PashaShun/PCB_Design/stm32f103/СП_СП1_merged.pdf

Формат
Кіл.
А4 | | ДК81.463421.001 ПЕ3 | Плата STM32F103С8T. Перелік елементів | 1
А3 | 4 Поз. | ДК81.463421.001 Е3 | Плата STM32F103С8T. Схема електрична принципова | 1
А2 | | ДК81.750706.001 СК | Плата. Складальне креслення | 1
А3 | 1
2 | C-0603 63 В 1 мкФ 10% Kemet | 1 | C1
3 | C-0603 63 В 20 пФ 10% Kemet | 4 | C2-C5
| C-0603 63 В 100 нФ 10% Kemet | 2 | C6,C7
5 | CASE-C_6032 63 В 330 мкФ 10% Kemet | 1 | C8
6 | C-0603 63 В 100 нФ 10% Kemet | 3 | C9-C11
7 | CASE-C_6032 63 В 100 мкФ 10% Kemet | 1 | C12
| 8 | | C-0603 63 В 100 нФ 10% Kemet | 1 | C13
| 9 | | CASE-C_6032 63 В 100 мкФ 10% Kemet | 1 | C14
Зм. | Лист | № докум. | Підп. | Дата
Аркушів
2

Інші вироби

Деталі

Документація

Підп. та дата

# ДК81.750706.001 СП

Інв. № подл.

Н. контр.
Затв. | Губар В.Ч.

Розроб.
Перев.

Аркуш

## Функціональний

1

годинник | НТУУ "КПІ Ім. Ігоря Сікорського" ФЕЛ, ДК-81
Шунь П.О. | Літ.
Адаменко І.О.

Конденсатори

Друкована плата

ДК81.463421.001

Справ. №
1
Позначення | Найменування

Підп. та дата

Примітки

Перв. застосув.

Зона

Взам. інв. № Інв. № дубл.

Копировал | Формат А4

Формат
Кіл.
15 Поз. 10 | TC2117-3.3VDBTR Microchip | 1 | DA1
11 | STM32F103VBH7 STMicroelectronics | 1 | DD1

2

13 | R-0603 0.1 Вт 10 кОм 10% Yageo | 1 | R1
14 | R-0603 0.1 Вт 100 кОм 10% Yageo | 2 | R2,R3
| R-0603 0.1 Вт 1 МОм 10% Yageo | 1 | R4
16 | R-0603 0.1 Вт 510 Ом 10% Yageo | 1 | R5
17 | R-0603 0.1 Вт 10 кОм 10% Yageo | 2 | R6,R7
18 | R-0603 0.1 Вт 1.5 кОм 10% Yageo | 1 | R8
| 19 | | R-0603 0.1 Вт 510 Ом 10% Yageo | 1 | R9
| 20 | | R-0603 0.1 Вт 20 Ом 10% Yageo | 2 | R10,R11

1

1

23 | OSC_8M LCSC | 1 | ZQ1
| 24 | | OSC_32.7K LCSC | 1 | ZQ2
| | ДК81.750706.001 | Арк.
Зм. | Підп. | Дата

Взам. інв. №

XP1

Інв. № дубл.

2

Інв. № подл.

Підп. та дата Підп. та дата

HL1,HL2

Кварцеві резонатори

2174507-2 TE Connectivity

Примітка

SB1

Резистори

Перемикачі

B3S-1100 Omron

Роз'єми

XL-0603QYGC KENTO

Пристрої індикації

Позначення | Найменування

Мікросхеми

21

Арк.

22

№ докум.

12

Зона

Копировал | Формат А4
