PashaShun/PCB_Design/documentation/Ел. розрахунок.docx

Електричний розрахунок друкованої плати

1. Визначення падіння напруги на найдовшому друкованому провіднику

Падіння напруги на друкованому провіднику визначається:

U_(пад) =(p∙I_(max) ∙l_(пр))/(b_(пр) ∙t_(пр)) ,

де ρ - питомий об'ємний опір для комбінованого позитивного методу виготовлення ДП,

ρ = 0,0175 (Ом∙мм^2)/м

lпр – максимальна довжина друкованого провідника, lпр=0,379м.

tпр - товщина провідника, tпр = 0,0965 мм

Imax – максимальний струм у провіднику, Imax = 67мА

U_(пад) =(p∙I_(max) ∙l_(пр))/(b_(max) ∙t_(пр))=(0,0175∙0,067∙0,379)/(0,25∙0,0965)=0,0184В

Розраховане падіння напруги не перевищує 5% від напруги живлення

(Ucc = 5В).

2. Визначення потужності втрат двосторонньої друкованої плати

Потужність втрат визначається:

Р_(втрат) =2∙π∙f∙C∙E_(жив)^2 ∙tgσ ,

де f=1, тому що розрахунок виконується на постійному струмі

tgσ – тангенс кута діелектричних втрат для матеріала ДП, tgσ =0,002 для матеріалу FR-4

С – ємність ДП

C=(0,009∙ε∙S_m)/h ,

де ε – діелектрична проникність, ε = 4,5 для FR4

Sm - площа металізації, Sm =3412,5 мм²

h - товщина ДП, мм

C=(0,009∙ε∙S_m)/h = (0,009∙4,5∙3412)/(1,5)=92,12нФ

Р =2∙π∙f∙C∙E_(жив)^2 ∙tgσ=2∙3,14∙1∙92,12 ∙10^(-9) ∙25∙0,002=0,28 нВт

3. Визначення ємності між двома сусідніми провідниками, які розташовуються на одній стороні ДП та мають однакову ширину

С=0,12∙ε∙l_(пр) ∙[lg(2∙S)/(b_(пр) +t_(пр))]^(-1) ,

де S – відстань між двома паралельними провідниками, S=0,6 мм

bпр - ширина друкованого провідника, мм

tпр - товщина друкованого провідника, мм

lпр - довжина взаємного перекриття двох паралельних провідників, 20 мм

С=0,12∙ε∙l_(пр) ∙[lg(2∙S)/(b_(пр) +t_(пр))]^(-1) =0,12∙4,5∙20∙[lg(2∙0,8)/(0,25+0,0965)]^(-1) =16,25 пФ

4. Визначення взаємної індуктивності двох паралельних провідників однакової довжини

М=0,02(l_(пр) lg(√(l_(пр)^2 -L_0^2)+l_(пр))/(L_0)-√(l_(пр)^2 -L_0^2)+l_(пр) ) , (5)

де lпр – довжина перекриття паралельних провідників, lпр=2.2 см

Lо-відстань між осьовими лініями двох паралельних провідників, Lо=0,1 см

М=0,02(l_(пр) lg(√(l_(пр)^2 -L_0^2)+l_(пр))/(L_0)-√(l_(пр)^2 -L_0^2)+l_(пр) )=

=0,02(2,2∙lg⁡((√(4,84-0,01)+2.2)/(0,1))-√(4.84-0,01)+2.2)= 0,18 нГн

Висновки: Падіння напруги на найдовшому провіднику - 0,0184В . Потужність втрат незнача і дорівнює 0,28 нВт . Паразитна ємність (16,25 пФ) та індуктивність (0,18 нГн) не впливають на роботу друкованого вузлу.
