PashaShun/PCB_Design/stm32f103/PCB_Project_ПЭ3.xls

Sheet: ДК81.463421.001. Первый лист.
ДК81.463421.001 | Перв. застосув. | ДК81.463421.001 | Поз. позна-чення |  |  | Найменування |  |  |  | Кіл. |  | Примітка
 |  |  |  |  |  | Конденсатори
 |  |  | C1 |  |  | C-0603 63 В 1 мкФ 10% Kemet |  |  |  | 1
 |  |  | C2-C5 |  |  | C-0603 63 В 20 пФ 10% Kemet |  |  |  | 4
 | Справ. № |  | C6,C7 |  |  | C-0603 63 В 100 нФ 10% Kemet |  |  |  | 2
 |  |  | C8 |  |  | CASE-C_6032 63 В 330 мкФ 10% Kemet |  |  |  | 1
 |  |  | C9-C11 |  |  | C-0603 63 В 100 нФ 10% Kemet |  |  |  | 3
 |  |  | C12 |  |  | CASE-C_6032 63 В 100 мкФ 10% Kemet |  |  |  | 1
 |  |  | C13 |  |  | C-0603 63 В 100 нФ 10% Kemet |  |  |  | 1
 |  |  | C14 |  |  | CASE-C_6032 63 В 100 мкФ 10% Kemet |  |  |  | 1
 | Підп. та дата |  |  |  |  | Мікросхеми
 |  |  | DA1 |  |  | TC2117-3.3VDBTR Microchip |  |  |  | 1
 |  |  | DD1 |  |  | STM32F103VBH7 STMicroelectronics |  |  |  | 1
 | Інв. № дубл.
 |  |  |  |  |  | Пристрої індикації
 | Взам. інв.№ |  | HL1,HL2 |  |  | XL-0603QYGC KENTO |  |  |  | 2
 | Підп. та дата
 |  |  |  |  |  |  |  |  | ДК81.463421.001ПЕ3
 |  |  | Зм. | Арк. | № докум. |  | Підп. | Дата
 | Інв. № подл. |  | Розроб. |  | Шунь П.О. |  |  |  | Плата STM32F103C8T6 |  | Літ. |  | Аркуш | Аркушів
 |  |  | Перев. |  | Адаменко І.О. |  |  |  |  |  |  |  | 1 | 2
 |  |  | Н.контр
 |  |  | Затв. |  | Губар В.Ч. |  |  |  | Перелік елементів

Sheet: 2
ДК81.463421.001 |  | Поз. позна- чення |  |  | Найменування |  |  |  | Кіл. | Примітка
 |  |  |  |  | Резистори
 |  | R1 |  |  | R-0603 0.1 Вт 10 кОм 10% Yageo |  |  |  | 1
 |  | R2,R3 |  |  | R-0603 0.1 Вт 100 кОм 10% Yageo |  |  |  | 2
 |  | R4 |  |  | R-0603 0.1 Вт 1 МОм 10% Yageo |  |  |  | 1
 |  | R5 |  |  | R-0603 0.1 Вт 510 Ом 10% Yageo |  |  |  | 1
 |  | R6,R7 |  |  | R-0603 0.1 Вт 10 кОм 10% Yageo |  |  |  | 2
 |  | R8 |  |  | R-0603 0.1 Вт 1.5 кОм 10% Yageo |  |  |  | 1
 |  | R9 |  |  | R-0603 0.1 Вт 510 Ом 10% Yageo |  |  |  | 1
 |  | R10,R11 |  |  | R-0603 0.1 Вт 20 Ом 10% Yageo |  |  |  | 2
 |  |  |  |  | Перемикачі
 |  | SB1 |  |  | B3S-1100 Omron |  |  |  | 1
 | Підп. та дата
 |  |  |  |  | Роз'єми
 |  | XP1 |  |  | 2174507-2 TE Connectivity |  |  |  | 1
 | Інв. № дубл.
 |  |  |  |  | Кварцеві резонатори
 | Взам. інв.№ | ZQ1 |  |  | OSC_8M LCSC |  |  |  | 1
 |  | ZQ2 |  |  | OSC_32.7K LCSC |  |  |  | 1
 | Підп. та дата
 | Інв. № подл.
 |  |  |  |  |  |  |  | ДК81.463421.001ПЭ3 |  |  | Аркуш
 |  |  |  |  |  |  |  |  |  |  | 2
 |  | Зм. | Арк. | № докум. |  | Підп. | Дата
