PashaShun/PCB_Design/project_Altium/PCB1.step

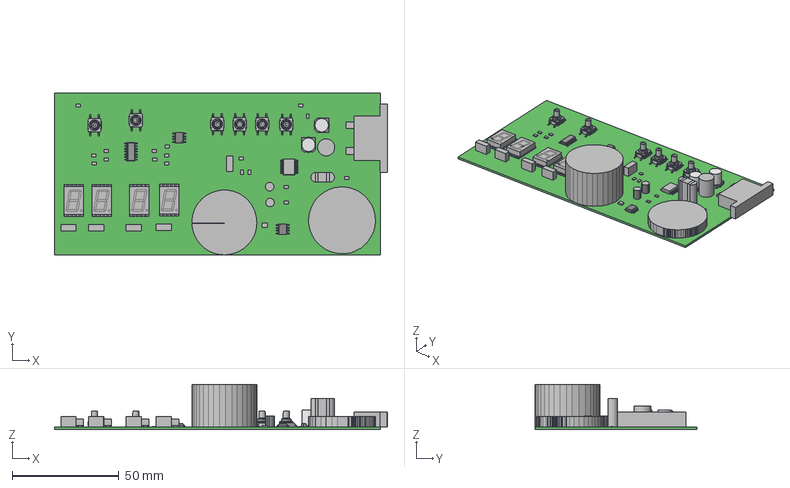
[picture p15: CAD file, 2021-06-25]
project_Altium/PCB1.step
155.8 x 75.9 x 21.1 mm
Extruded x 37
CAP_UCD_6P3X7P7_NCH x 2
21-0041B_8_MXM x 2
_KSC6_-_body x 6
_KSC6__-_button x 6
_KSC6_-_cover x 6
_KSC61G_pin x 24
SSOP20_MC_MCH_RGB8421504
BODY-SO
LEAD-SO x 14
PIN1-ID
XZFxx10x_RGB8421504 x 4
