PashaShun/PCB_Design/(list of files, cad)

Other CAD files:
project_Altium/PCB1.DWG
