PashaShun/PCB_Design/stm32f103/Plata.pdf

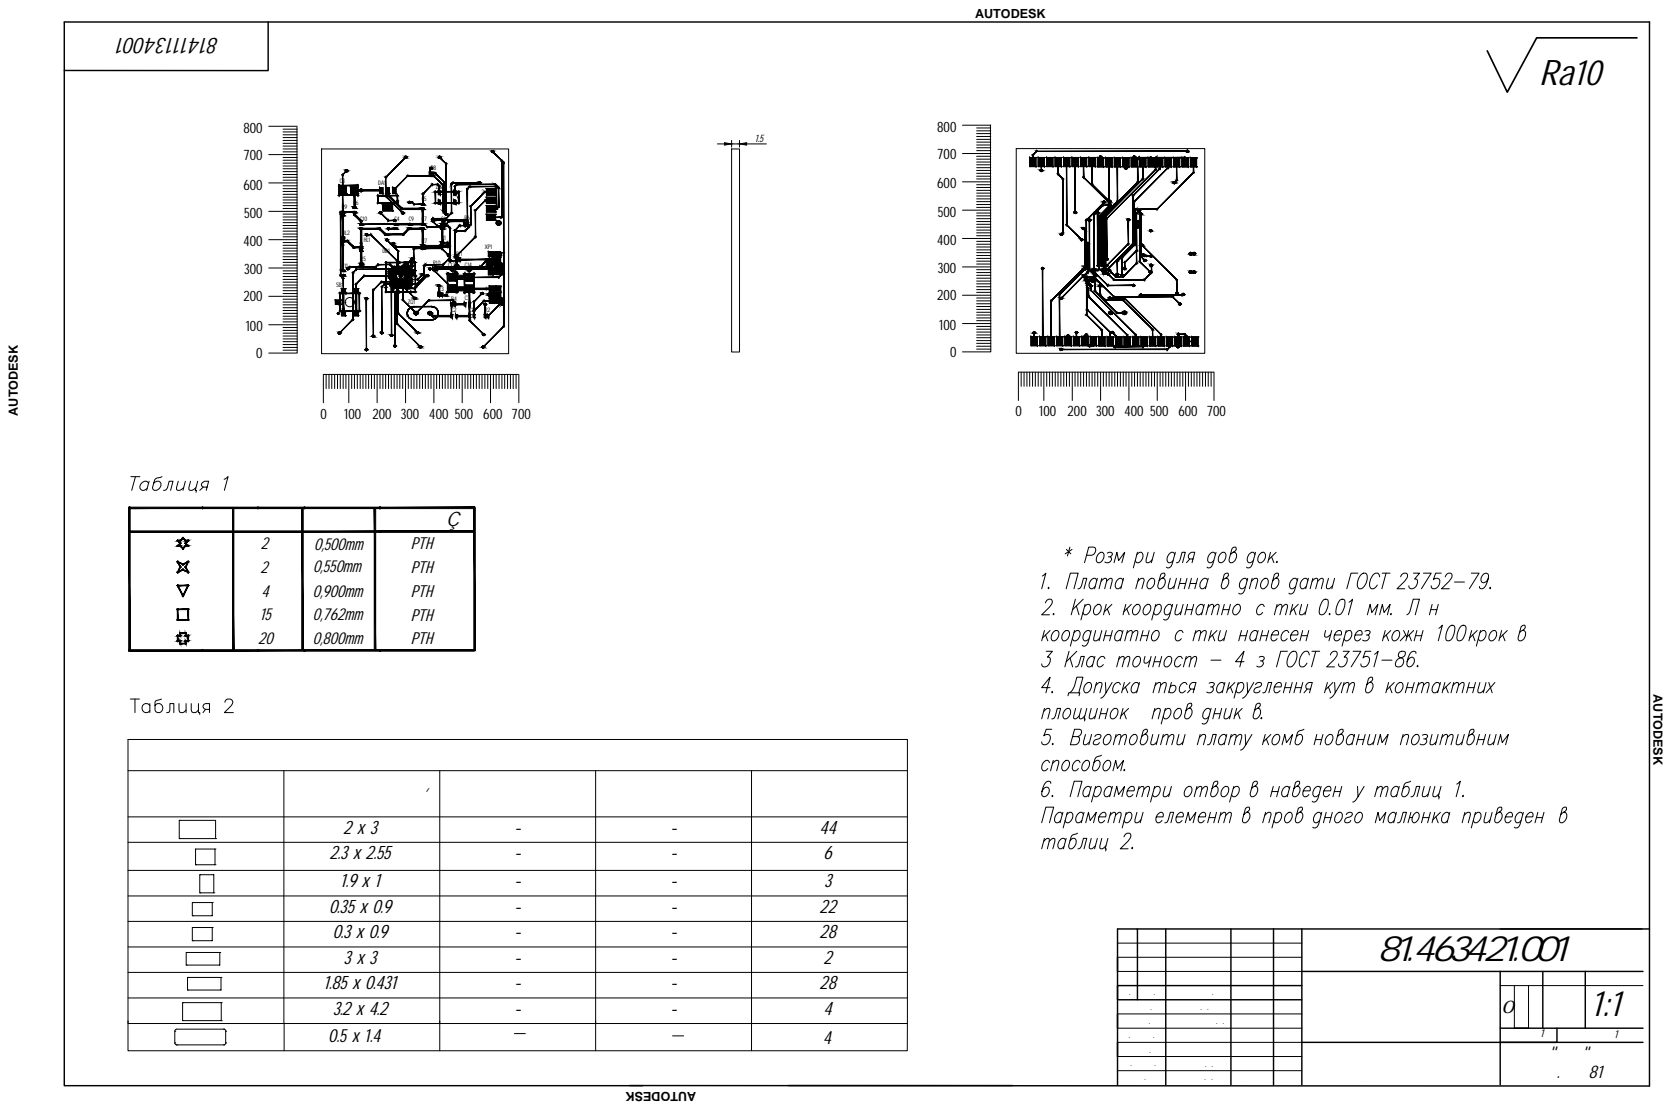
[picture p16: page 1]

ВЫПОЛНЕНО В СТУДЕНЧЕСКОЙ ВЕРСИИ ПРОГРАММЫ AUTODESK

Позначення | | Розмір | Металізаія

Кількість 224 15 20 | 0,500mm 0,550mm 0,900mm 0,762mm 0,800mm | PTH PTH PTH PTH PTH

Позначення контактних майданчиків

Умовне позначення | Розміри майданчика , мм | закруглення кутів Наявність | Радіус закруглення | кутів | Кількість КМ

2 x 3 | - | | - | 44
2.3 x 2.55 | - | | - | 6
1.9 x 1 | - | | - | 3
0.35 x 0.9 | - | | - | 22
0.3 x 0.9 | - | | - | 28
3 x 3 | - | | - | 2
1.85 x 0.431 | - | | - | 28
3.2 x 4.2 | - | | - | 4
0.5 x 1.4 | | | | 4

Зм. | Арк. | докум. | Підпис | Дата
Розроб. Перев. .Контр. .контр. Затв.

Аркуш 1
Аркушів 1 НТУУ "КПІ" ФЕЛ гр. ДК81

Губар В. .
