PashaShun/PCB_Design/stm32f103/Skladalne.pdf

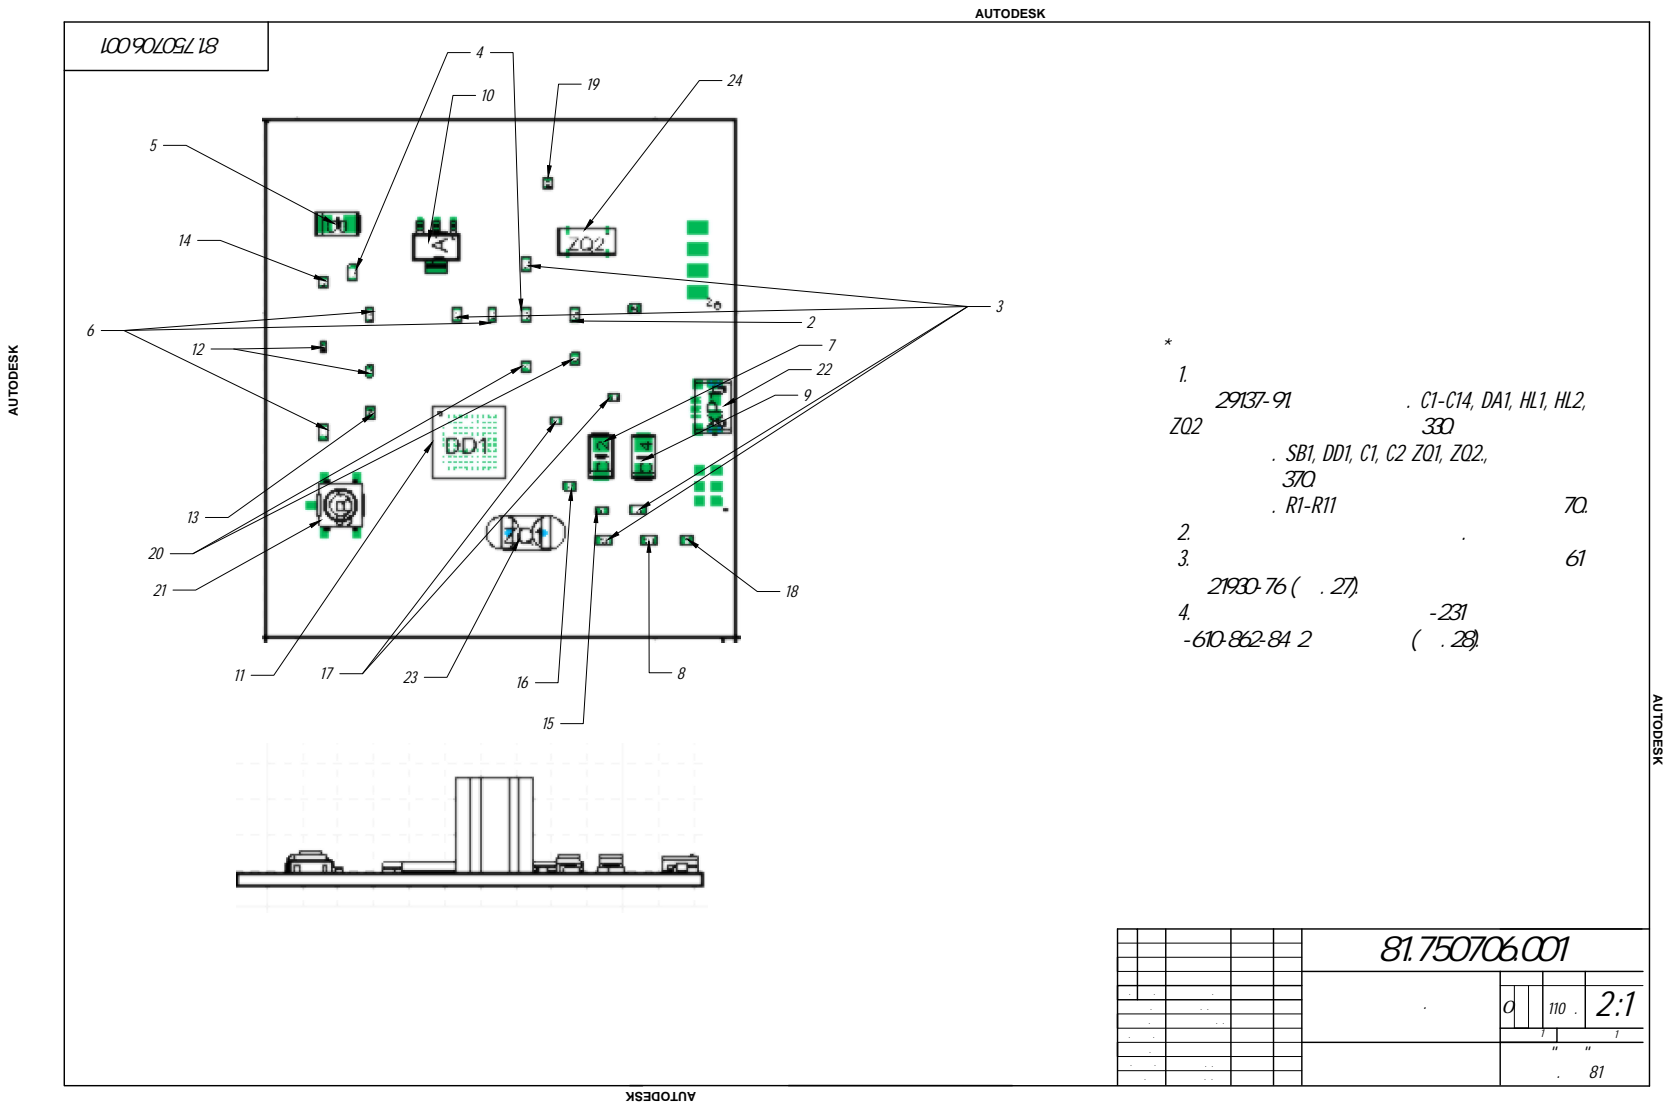
[picture p17: page 1]
Шунь П.О. Адаменко І . .; Плата. Складальне креслення; Розміри для довідок; Маркування елементів умовні. 3.; Усі виводи елементів паяти припоєм ПОС 61

ВЫПОЛНЕНО В СТУДЕНЧЕСКОЙ ВЕРСИИ ПРОГРАММЫ AUTODESK

1. Встановлення елементів здійснювати згідно
ГОСТ 29137-91. Елементи поз. C1-C14, DA1, HL1, HL2,
ZQ2 встановити за варіантом 330. Елементи поз. SB1, DD1, C1, C2 ZQ1, ZQ2.,встановити

за варіантом 370. Елементи поз. R1-R11 встановити за варіантом 70..

ГОСТ 21930-76 (поз. 27).
4. Плату покрити лаком УР-231
ТУ-610-862-84У2 в два шари (поз. 28).

Зм. | Арк. | докум. | Підпис | Дата

Розроб. Перев.

.Контр.

Аркуш 1
Аркушів 1 НТУУ "КПІ" ФЕЛ гр. ДК81

.контр. Затв. | | Губар В. .
