PashaShun/PCB_Design/documentation/Plata.pdf

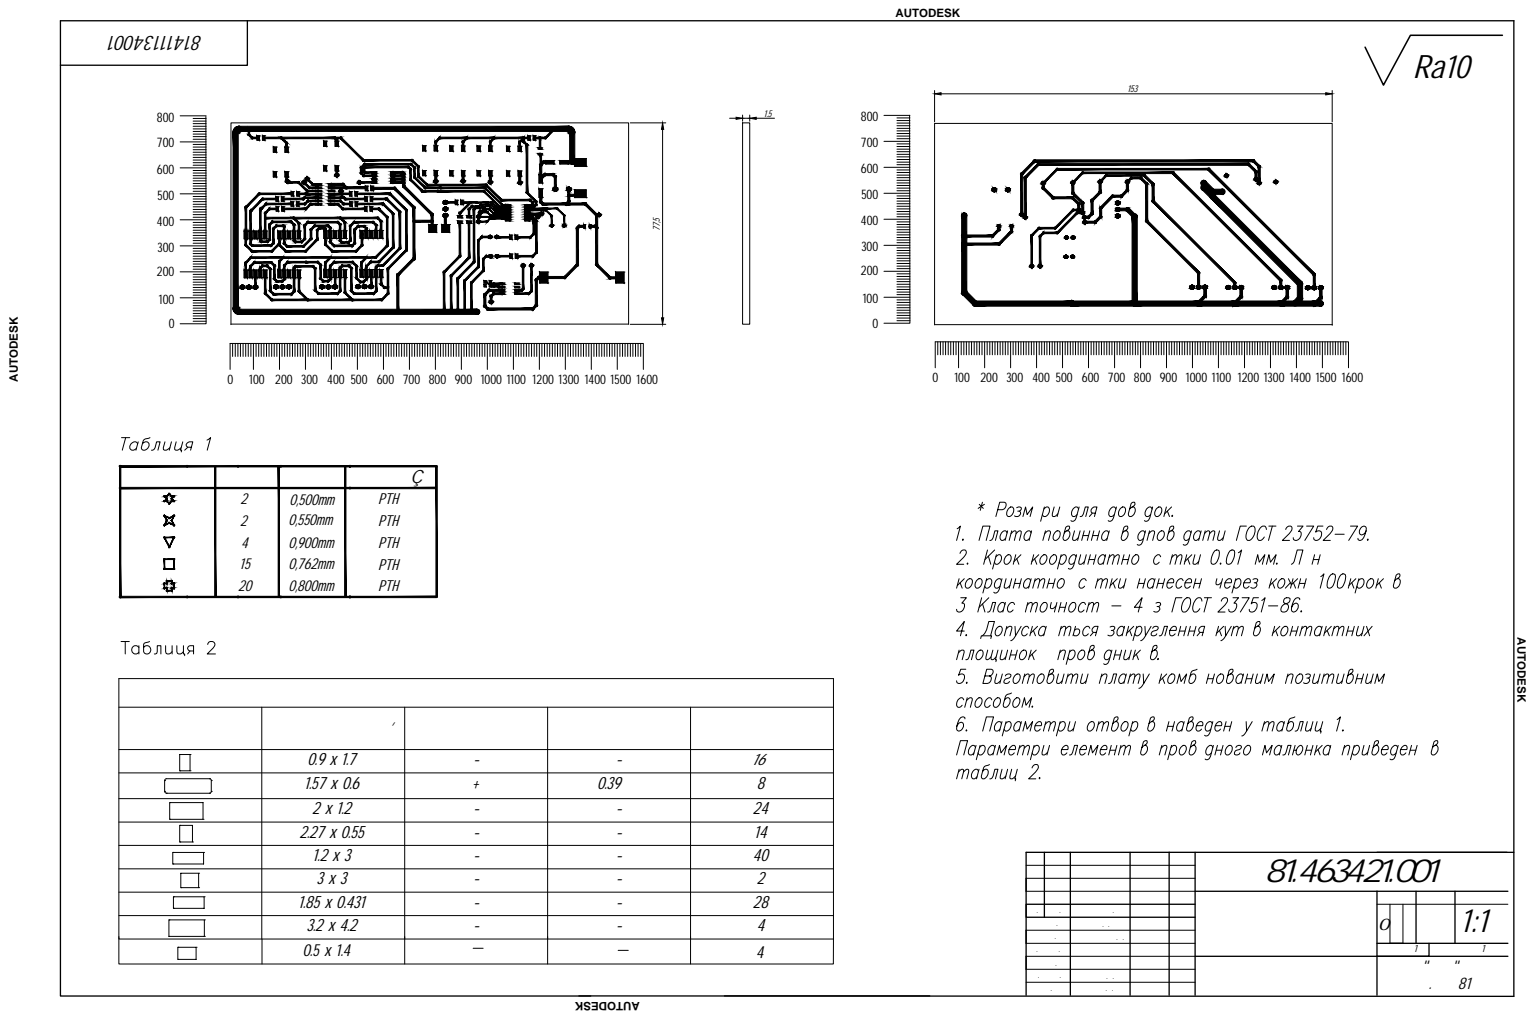
[picture p18: page 1]
Розроб. Перев.; Шунь П.О. Адаменко І . .; Друкована плата

ВЫПОЛНЕНО В СТУДЕНЧЕСКОЙ ВЕРСИИ ПРОГРАММЫ AUTODESK

Позначення контактних майданчиків

Умовне позначення | Розміри майданчика , мм | закруглення кутів Наявність | Радіус закруглення | кутів | Кількість КМ

0.9 x 1.7 | - | | - | 16
1.57 x 0.6 | + | | 0.39 мм | 8
2 x 1.2 | - | | - | 24
2.27 x 0.55 | - | | - | 14
1.2 x 3 | - | | - | 40
3 x 3 | - | | - | 2
1.85 x 0.431 | - | | - | 28

Зм. | Арк. | докум. | Підпис | Дата

.Контр.

Аркуш 1
Аркушів 1 НТУУ "КПІ" ФЕЛ гр. ДК81

.контр. Затв. | Губар В. .
