PashaShun/PCB_Design/documentation/Складальне креслення.pdf

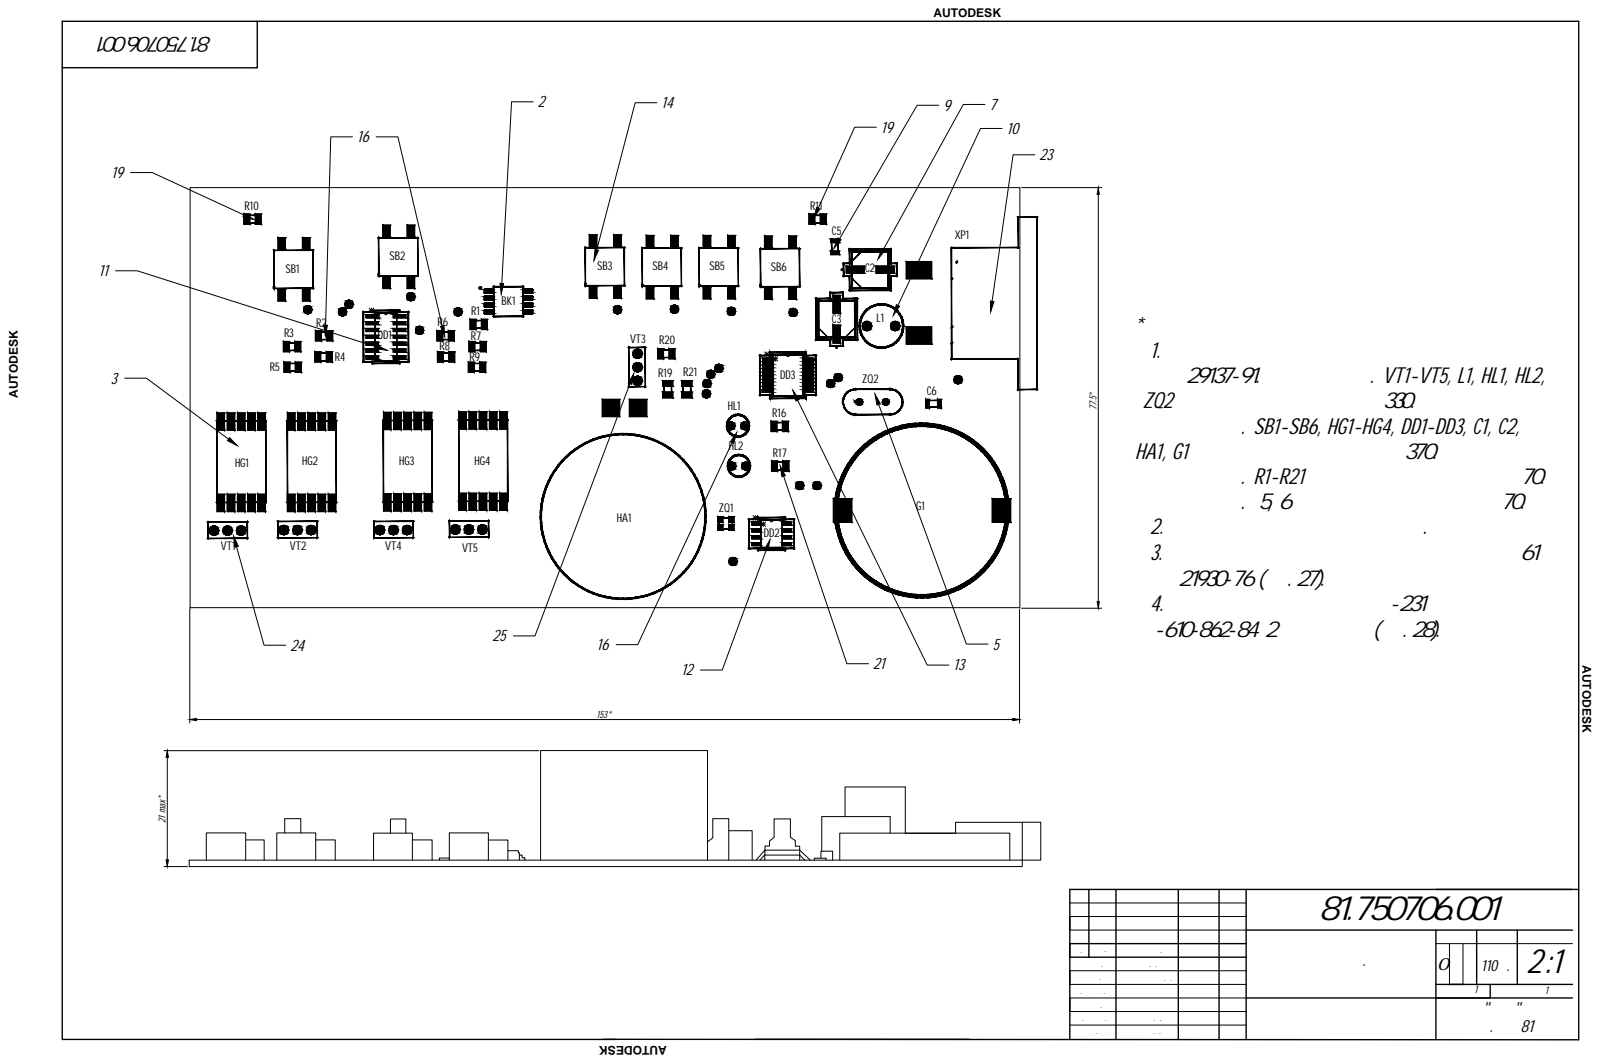
[picture p19: page 1]

ВЫПОЛНЕНО В СТУДЕНЧЕСКОЙ ВЕРСИИ ПРОГРАММЫ AUTODESK

1. Встановлення елементів здійснювати згідно
ГОСТ 29137-91. Елементи поз. VT1-VT5, L1, HL1, HL2,
ZQ2 встановити за варіантом 330. Елементи поз. SB1-SB6, HG1-HG4, DD1-DD3, C1, C2,

HA1, G1 встановити за варіантом 370. Елементи поз. R1-R21 встановити за варіантом 70.

Елементи поз. С5,С6 встановити за варіантом 70.

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

Зм. | Арк. | докум. | Підпис | Дата

Розроб. Перев.

.Контр.

Аркуш 1
Аркушів 1 НТУУ "КПІ" ФЕЛ гр. ДК81

.контр. Затв. | | Губар В. .
