PashaShun/PCB_Design/(list of files, drawings)

Other design files:
project_Altium/PCB1.PcbDoc
project_Altium/PcbLib1.PcbLib
project_Altium/Schlib1.SchLib
project_Altium/Sheet1.SchDoc
project_Altium/Sunshine.PrjPcb
stm32f103/PCB1.PcbDoc
stm32f103/PcbLib1.PcbLib
stm32f103/Schlib1.SchLib
stm32f103/Sheet1 (1).SchDoc
